martinhol221/SIM800L_DTMF_control/img/1.6x4.JPG

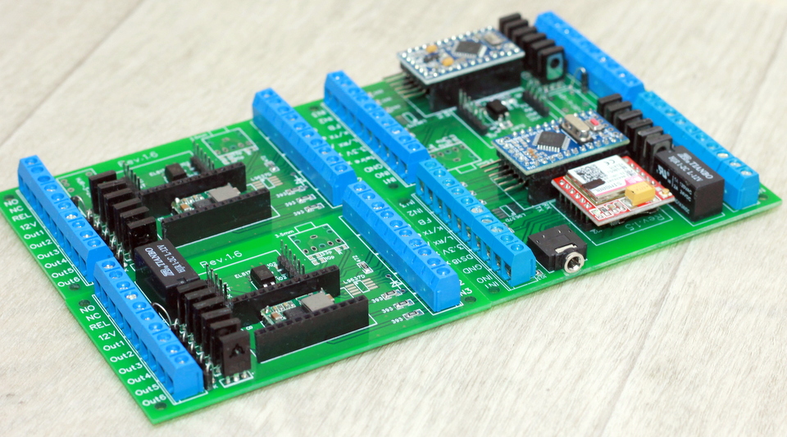
img/1.6x4.JPG
