martinhol221/SIM800L_DTMF_control/img/1.7.6.bottom.jpg

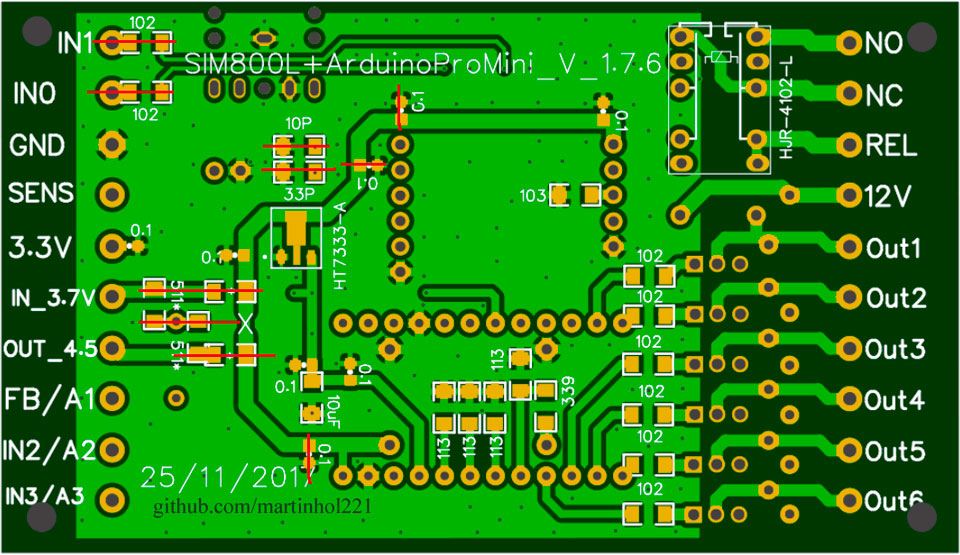
img/1.7.6.bottom.jpg
