martinhol221/SIM800L_DTMF_control/img/1.7.6.top.jpg

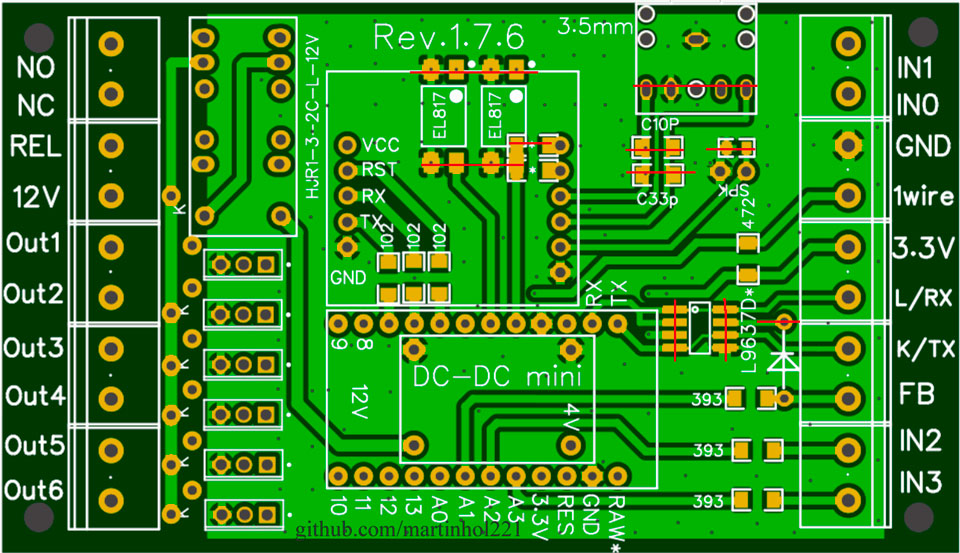
img/1.7.6.top.jpg
