martinhol221/SIM800L_DTMF_control/img/1N4007.jpg

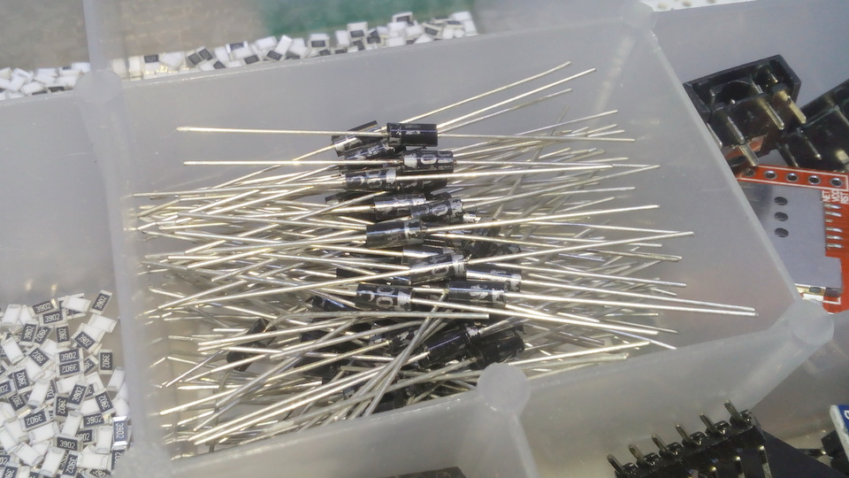
img/1N4007.jpg
