martinhol221/SIM800L_DTMF_control/img/5.08.jpg

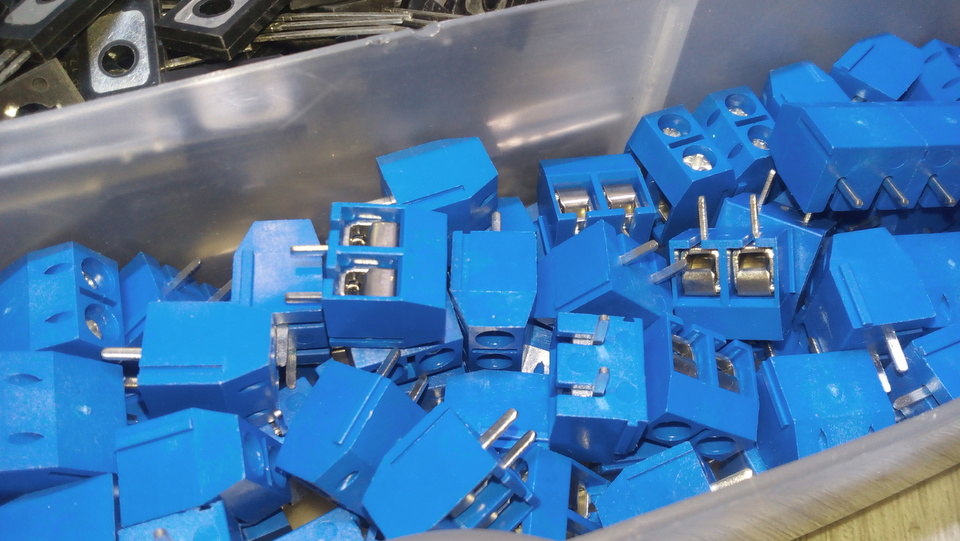
img/5.08.jpg
