martinhol221/SIM800L_DTMF_control/img/139.JPG

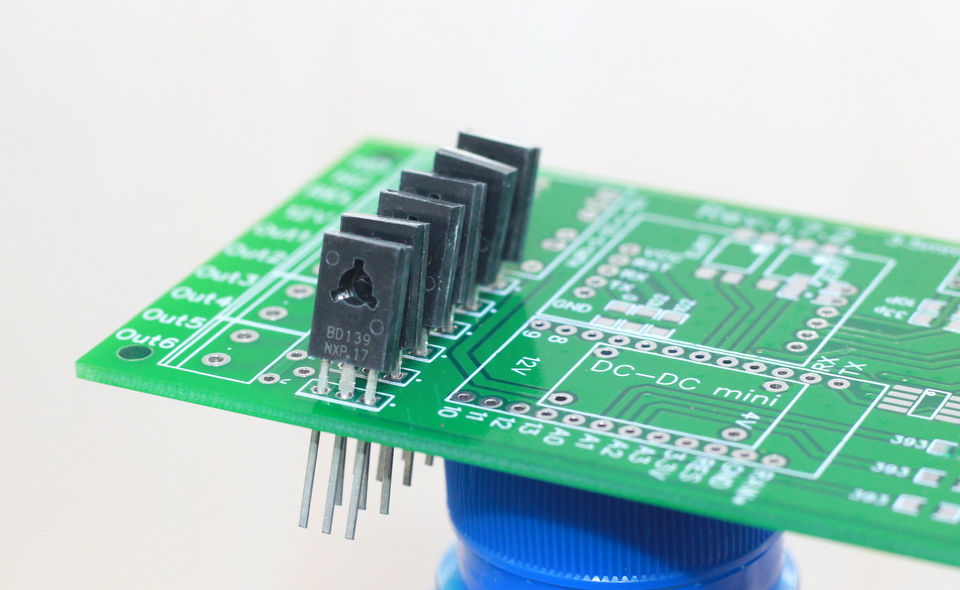
img/139.JPG
