martinhol221/SIM800L_DTMF_control/img/1206.jpg

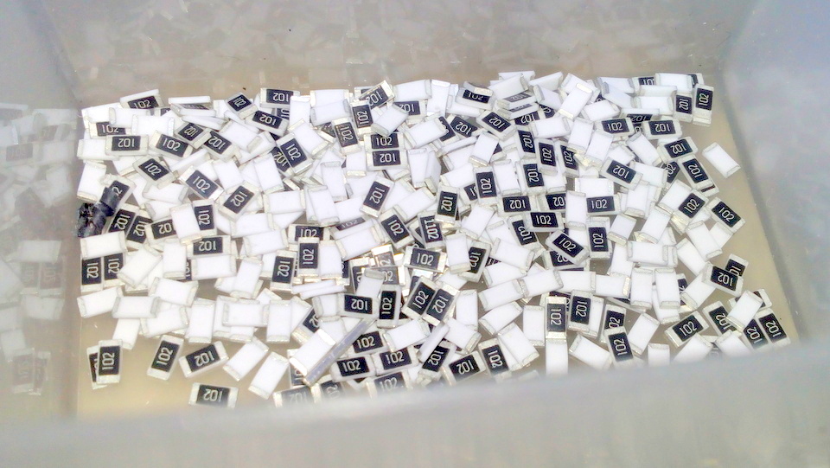
img/1206.jpg
