martinhol221/SIM800L_DTMF_control/img/+3DS18B20.JPG

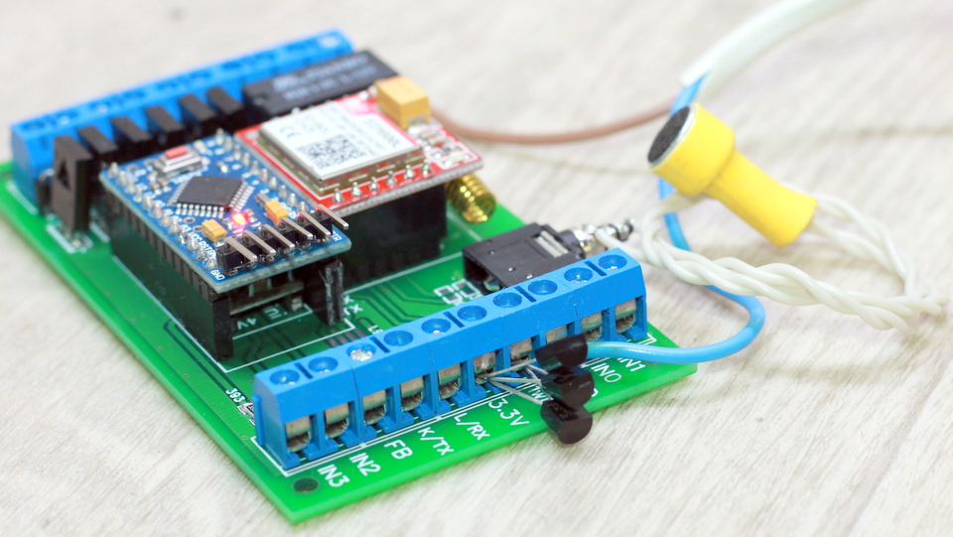
img/+3DS18B20.JPG
