martinhol221/SIM800L_DTMF_control/img/+ANT.JPG

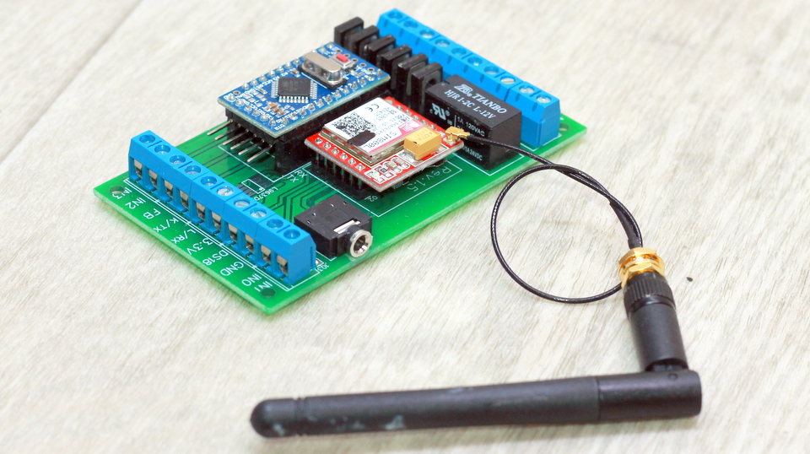
img/+ANT.JPG
