martinhol221/SIM800L_DTMF_control/img/+BD139+1N4007.JPG

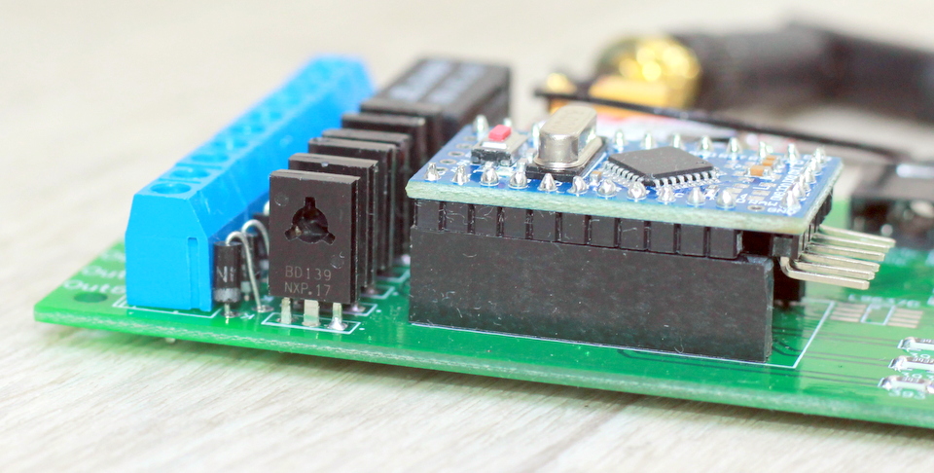
img/+BD139+1N4007.JPG
