martinhol221/SIM800L_DTMF_control/img/Arduino+Sim800l.JPG

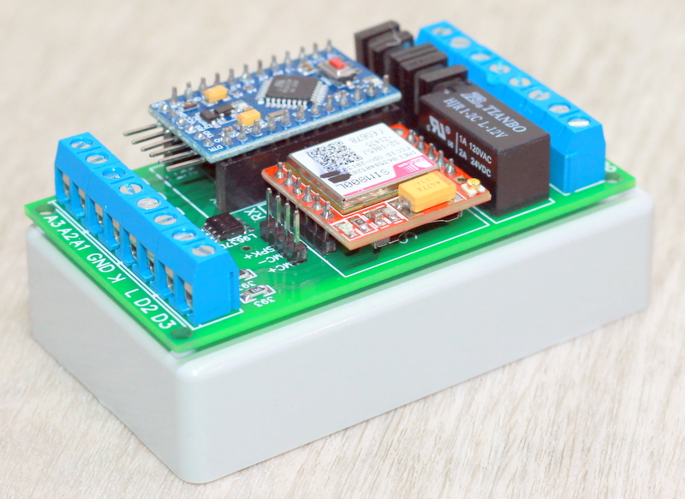
img/Arduino+Sim800l.JPG
