martinhol221/SIM800L_DTMF_control/img/ArduinoProMini.jpg

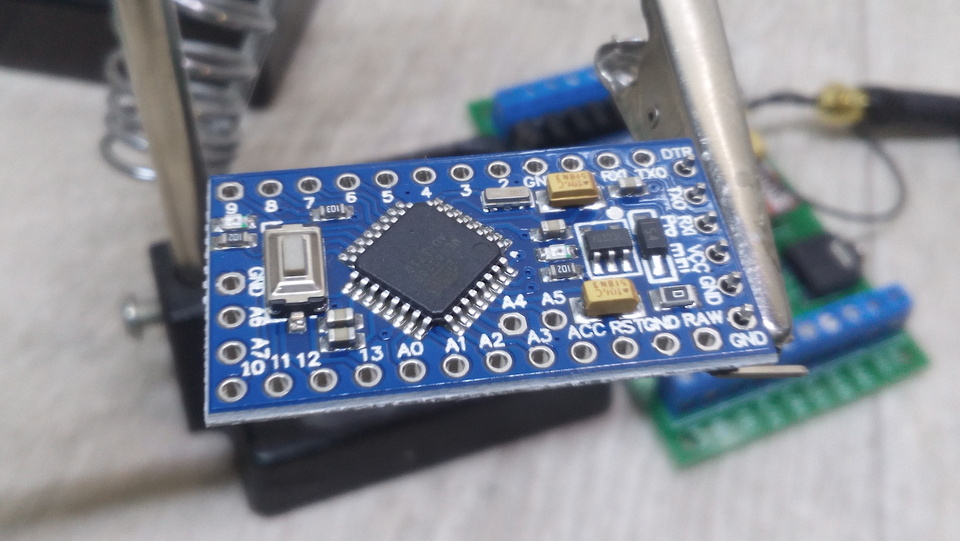
img/ArduinoProMini.jpg
