martinhol221/SIM800L_DTMF_control/img/autostart.jpg

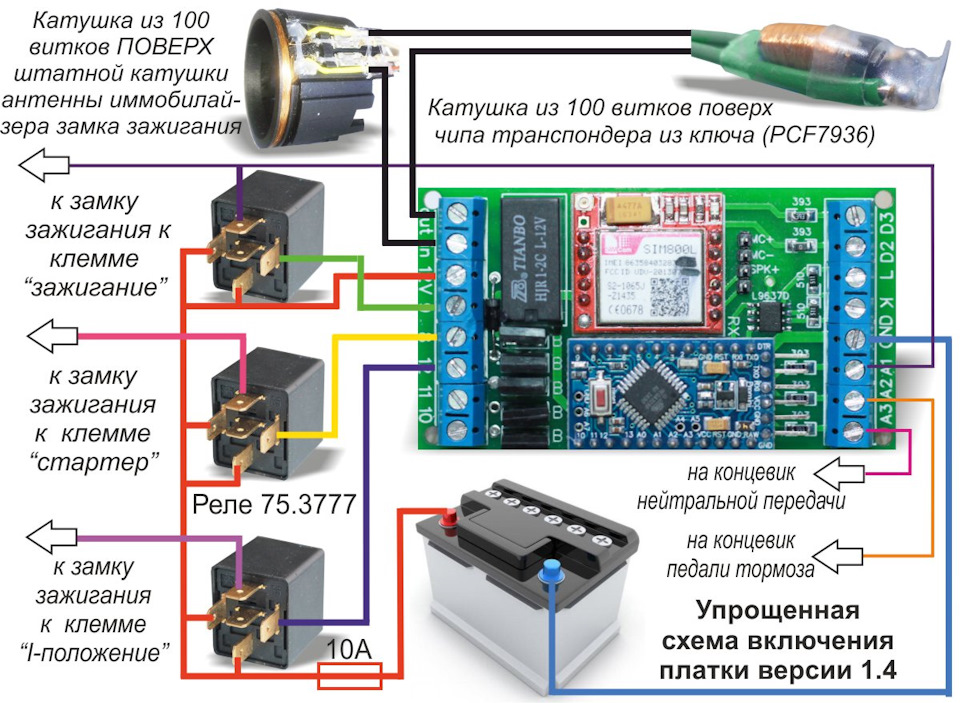
img/autostart.jpg
