martinhol221/SIM800L_DTMF_control/img/BD139.jpg

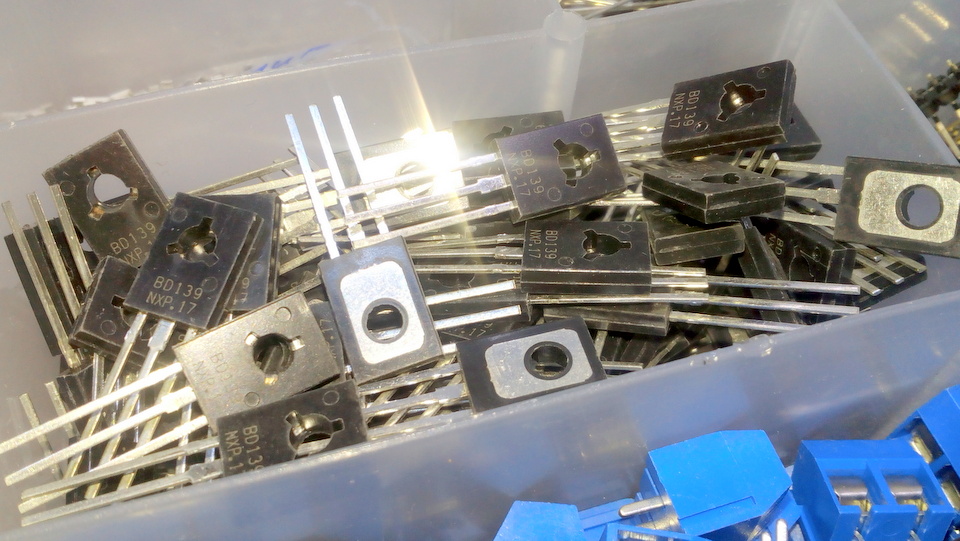
img/BD139.jpg
