martinhol221/SIM800L_DTMF_control/img/DC-DC-Mini-27K.jpg

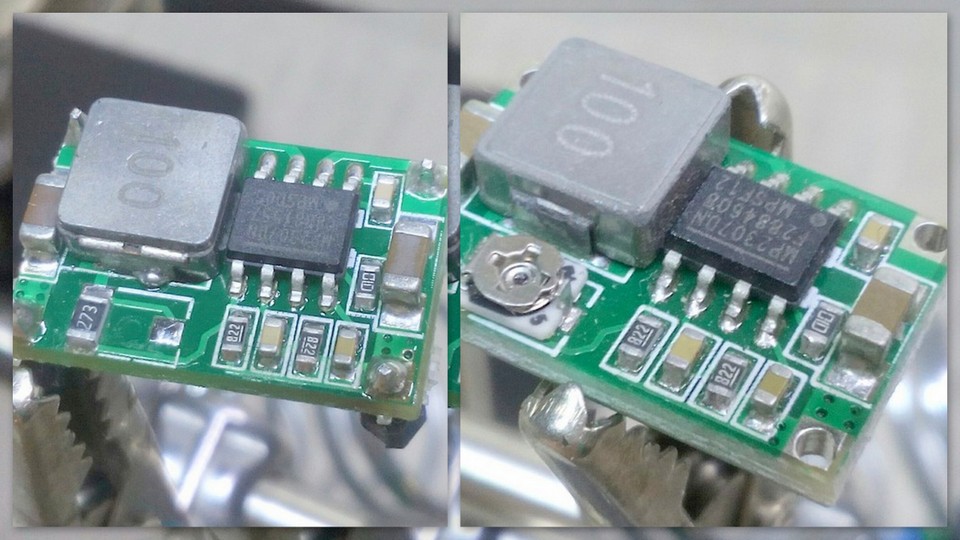
img/DC-DC-Mini-27K.jpg
