martinhol221/SIM800L_DTMF_control/img/Ds18B20.jpg

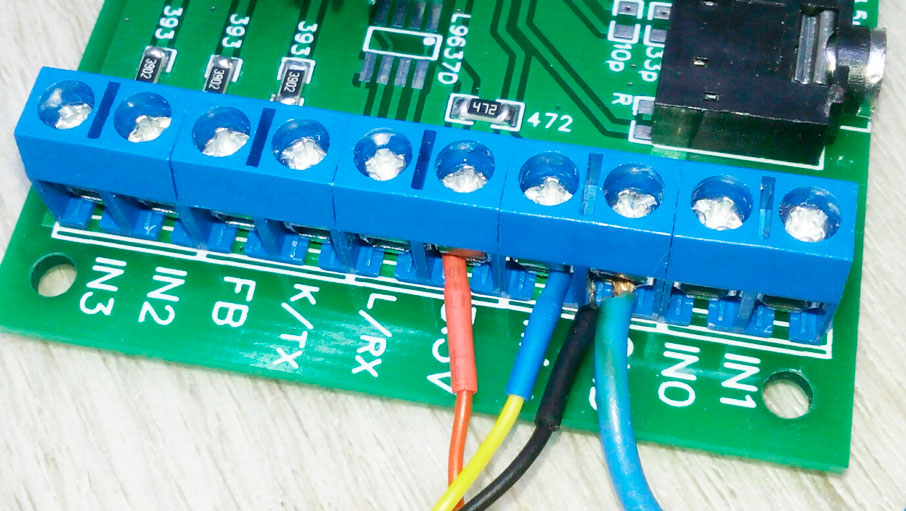
img/Ds18B20.jpg
