martinhol221/SIM800L_DTMF_control/img/HJR1-2CL12V.jpg

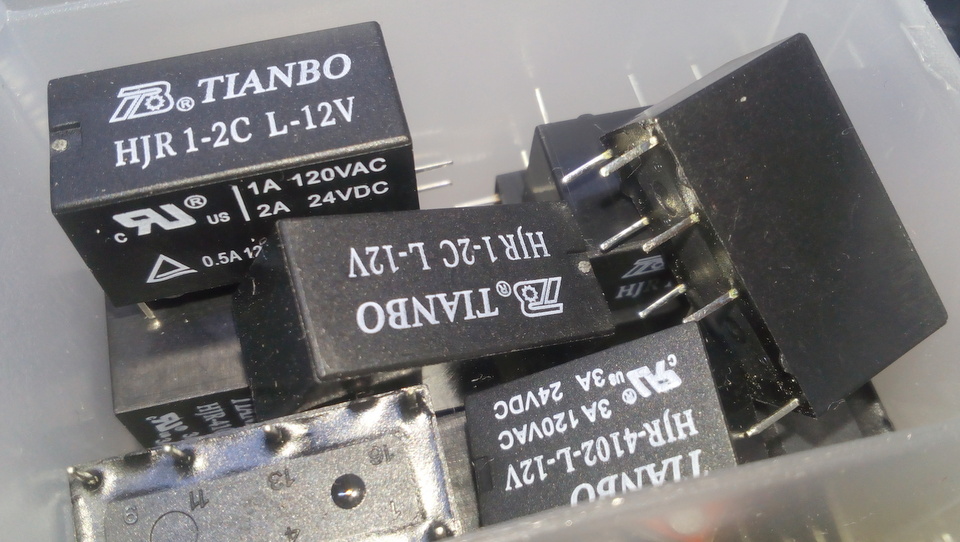
img/HJR1-2CL12V.jpg
