martinhol221/SIM800L_DTMF_control/img/inSMS3.jpg

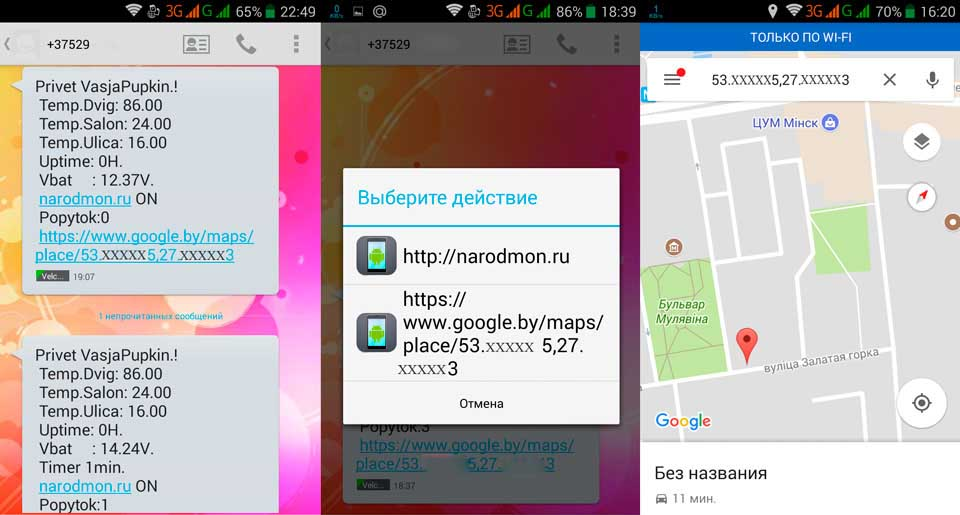
img/inSMS3.jpg
