martinhol221/SIM800L_DTMF_control/img/load_audio.JPG

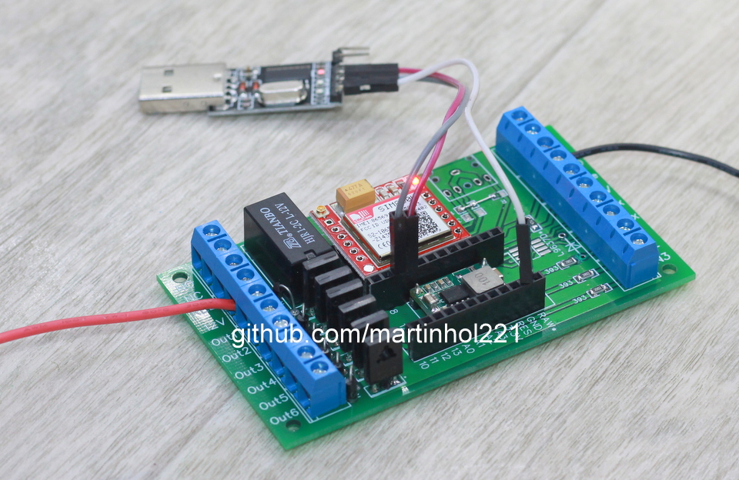
img/load_audio.JPG
