martinhol221/SIM800L_DTMF_control/img/No modem.JPG

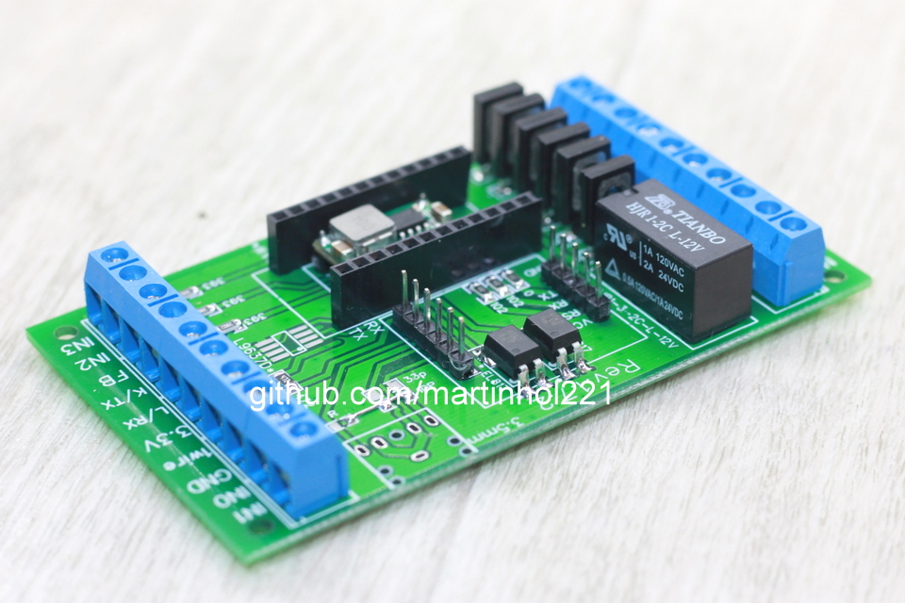
img/No modem.JPG
