martinhol221/SIM800L_DTMF_control/img/Series_ArmFile_Download_v1.00.JPG

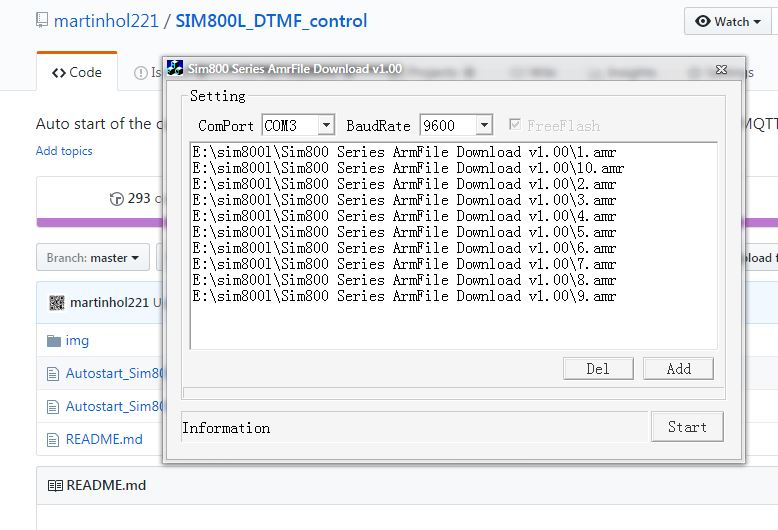
img/Series_ArmFile_Download_v1.00.JPG
