martinhol221/SIM800L_DTMF_control/img/Sim800L_red.jpg

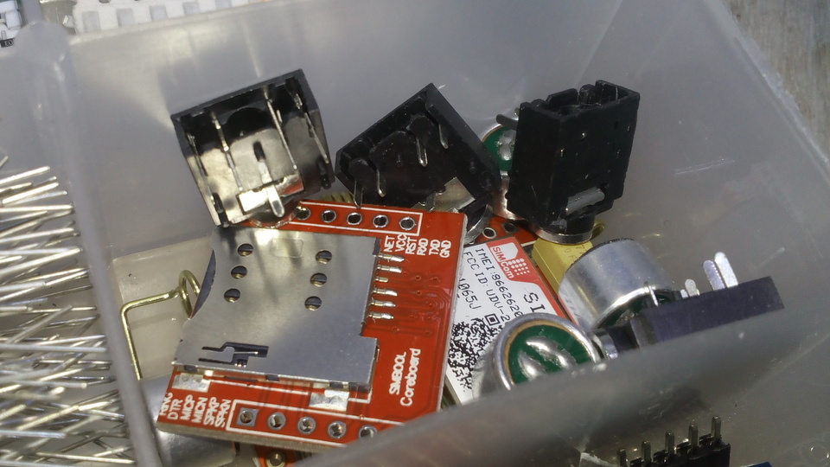
img/Sim800L_red.jpg
