martinhol221/SIM800L_DTMF_control/img/SIM.JPG

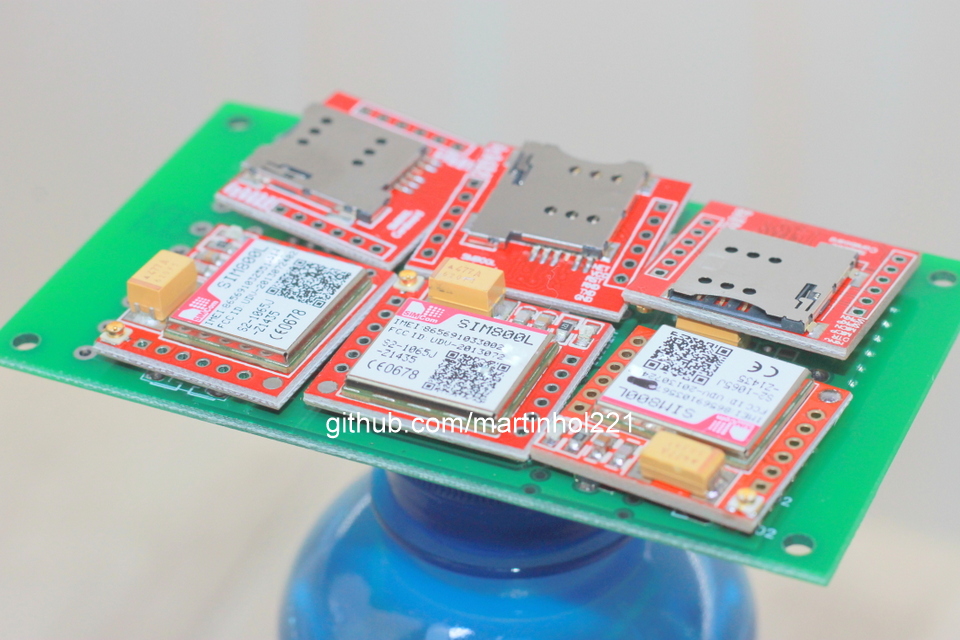
img/SIM.JPG
