martinhol221/SIM800L_DTMF_control/img/TempDS0-StTime_Timer.JPG

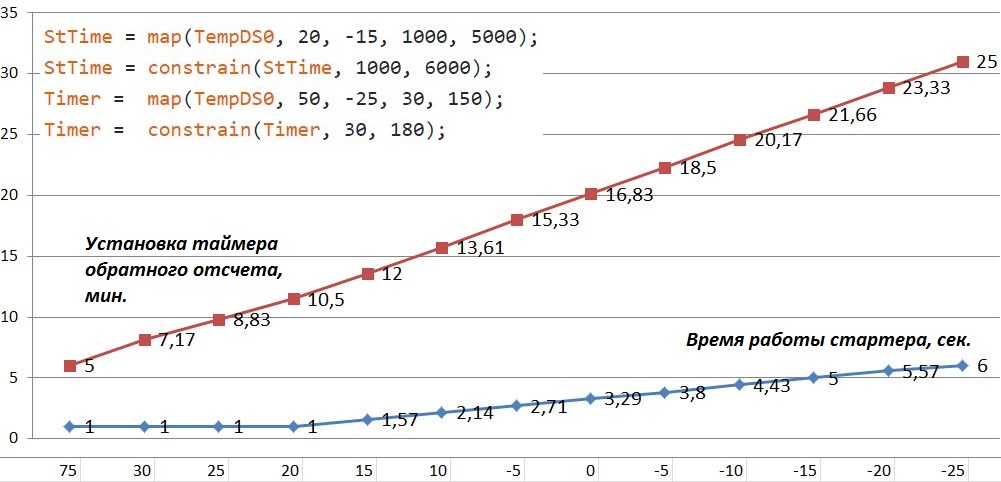
img/TempDS0-StTime_Timer.JPG
