martinhol221/SIM800L_DTMF_control/img/UART.JPG

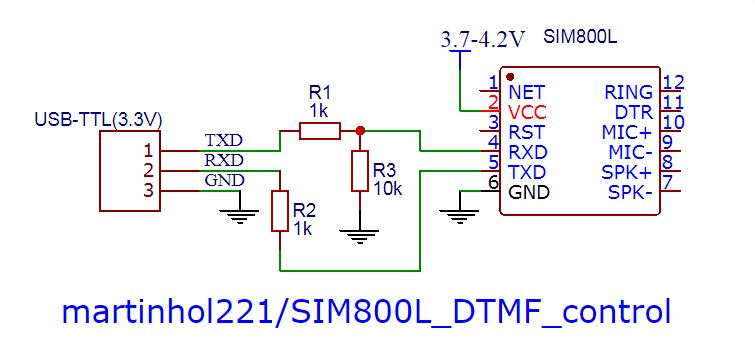
img/UART.JPG
