martinhol221/SIM800L_DTMF_control/img/lower_soldering.JPG

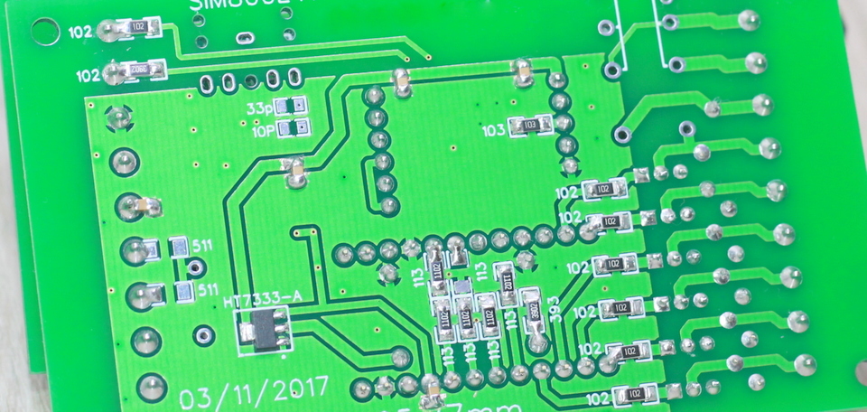
img/lower_soldering.JPG
