martinhol221/SIM800L_DTMF_control/img/upper_soldering.JPG

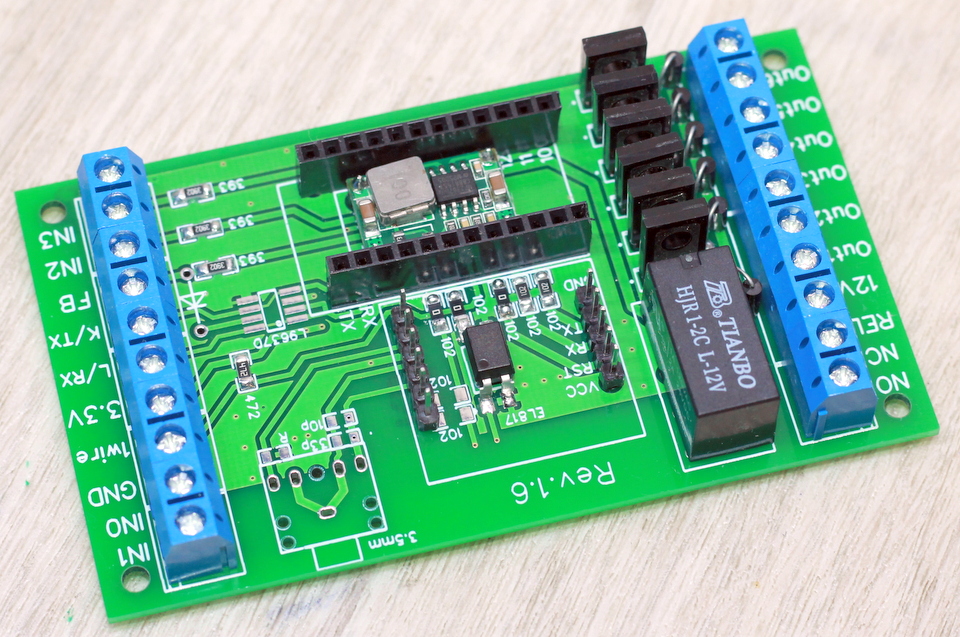
img/upper_soldering.JPG
