martinhol221/SIM800L_DTMF_control/(threads)

Thread 2 (2019-02-12):

Firmware 1418B04SIM800L24

steluis, 2019-02-12:
Where can I download the software version you mention 1418B04SIM800L24 ?
Seems that it is not present in SumCom official site.

Thank you.

roamirwilliams, 2020-08-07:
Revision:1418B05SIM800L24

https://yadi.sk/d/90-nlF22p7XN7A

bikicviki, 2023-02-26:
Did anybody find revision 1418B04SIM800L24 ?
Thanks in advance ...

iterr0R, 2023-04-11:
> Did anybody find revision 1418B04SIM800L24 ? Thanks in advance ...

Did you find it or are u still looking?

bikicviki, 2023-04-11:
No I didn't but problem was gsm modul sim800L not firmware .. Thakns for reply .. :)

HONAHONDE, 2023-12-09:
> > Quelqu'un a-t-il trouvé la révision 1418B04SIM800L24 ? Merci d'avance ...
>
> L'avez-vous trouvé ou vous cherchez toujours ?

je le cherche moi, pouvez-vous m'aider ?

HONAHONDE, 2023-12-09:
> > Did anybody find revision 1418B04SIM800L24 ? Thanks in advance ...
>
> Did you find it or are u still looking?

I'm looking for it, can you help me?

Electro-Gamma, 2024-08-05:
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

Are you find it??

bikicviki, 2024-08-12:
No I did not ..

On Mon, Aug 5, 2024 at 6:51 PM Electro-Gamma ***@***.***>
wrote:

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

Thread 3 (2019-12-30):

dtmf

atulgo, 2019-12-30:
Detection of DTMF tones in my SIM800L module.

I get "OK" when I send 'AT+DDET=1,1000,1,1* ' over uart .
But it doesnt seem to detect anything afterwards.
Perhaps I am doing something wrong.
Would be great to get some feedback.

regards
Atul
ref : *SIM800 Series_AT Command Manual_V1.09
