martinhol221/SIM800L_DTMF_control/img/Shema.pdf

4.0V

3.3V

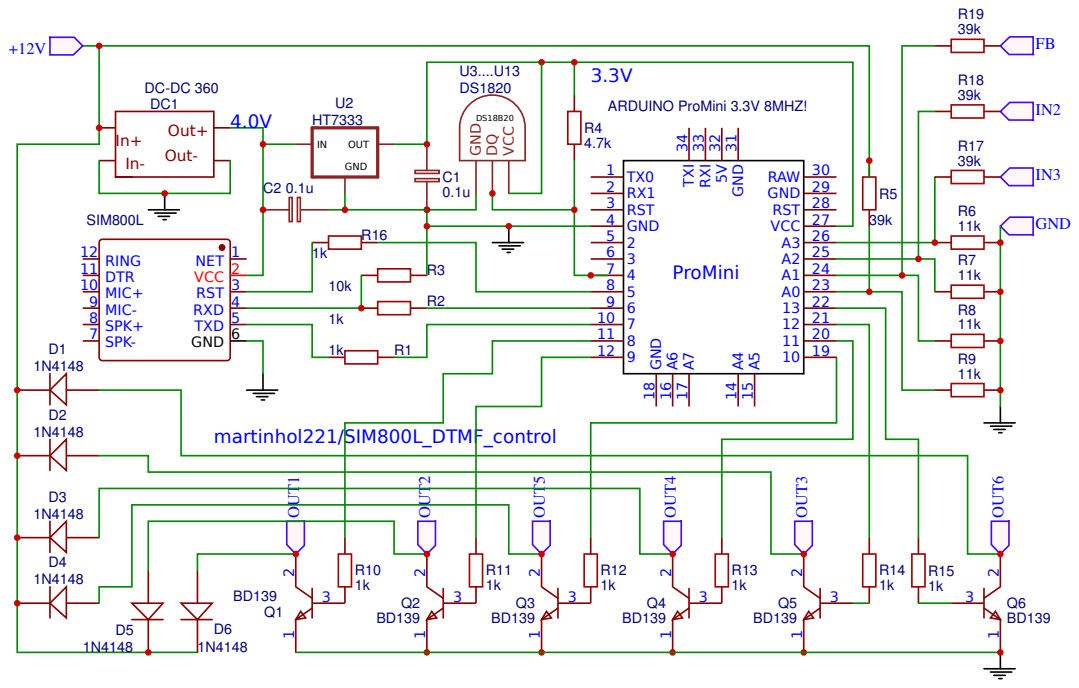
[picture p41: page 1]

GND 6 SPK- 7 SPK+ 8 MIC- 9 MIC+ 10 DTR 11 RING 12
