martinhol221/SIM800L_DTMF_control/(list of files, drawings)

Other design files:
SIM800L+ArduinoProMini-81x46mm.lay6
SIM800L+ArduinoProMini-81x70mm.lay6
