martinhol221/SIM800L_DTMF_control/img/RelTester.ino

// the setup function runs once when you press reset or power the board
void setup() {
  // initialize digital pin LED_BUILTIN as an output.
  pinMode(8, OUTPUT);
    pinMode(9, OUTPUT);
      pinMode(10, OUTPUT);
        pinMode(11, OUTPUT);
          pinMode(12, OUTPUT);
}

// the loop function runs over and over again forever
void loop() {
  digitalWrite(8, HIGH),  delay(1000), digitalWrite(8, LOW), delay(1000);   
  digitalWrite(9, HIGH),  delay(1000), digitalWrite(9, LOW), delay(1000);   
  digitalWrite(12, HIGH), delay(1000), digitalWrite(12, LOW), delay(1000);   
  digitalWrite(11, HIGH), delay(1000), digitalWrite(11, LOW), delay(1000);   
  digitalWrite(10, HIGH), delay(1000), digitalWrite(10, LOW), delay(1000);   
  digitalWrite(13, HIGH), delay(1000), digitalWrite(13, LOW), delay(1000);                      
}
