martinhol221/SIM800L_DTMF_control/(commit log)

2017-05-05 Слой паяльной маски на плату
2017-05-05 Печатная плата, негативная (для фоторезиста)
2017-05-05 Печатная плата, позитивная (для ЛУТа)
    Модемы SIM800L и M590 для Arduino ProMini под разные корпуса
2017-05-05 Расположение деталей на платах
    Расположение деталей на платах под разные корпуса, вид со стороны пайки
2017-05-05 Схема блока управления на модеме SIM800L
    Схема блока управления на модеме SIM800L в самой полной версии, в отличии от лайт версии имеет зарядку и литиевый аккумулятор.
2017-05-05 Схема подключения блока к автомобилю
    Схема подключения концевики педалей, датчики температуры, антенна эммобилайзера, силовое реле и другое
2017-05-05 Скетч для Arduino для GSM модема SIM800L
    Функции: обработка входящего звонка с заданным номером, реагирование на ввод DTMF команд (отправка смс отчета о состоянии систем и температуре с датчиков), команда запуска (3 попытки с контролем по датчику давления или зарядки), команда остановки двигателя.
2017-05-05 Исходники платы для SIM800L+Arduino 82x46мм
    [SIM800L+ArduinoProMini-81x46mm.lay6]
2017-05-05 Исходники платы для SIM800L+Arduino 82x70мм
    с платой защиты и литиевым аккумулятором типа 18650
    [SIM800L+ArduinoProMini-81x70mm.lay6]
2017-06-15 Изменения в цикле зпуска
2017-07-09 Скетч для управления Webasto
2017-07-09 Скетч управления Webasto
2017-10-04 Update Autostart_Citroen_V4.0_K-line_L9637D.ino
    added an additional relay for the first position of the ignition lock
2017-10-04 added an additional relay
    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
2017-10-10 добавлен автопрогрев при -18
2017-10-29 Create PCB
2017-11-09 кардинально изменен
2017-11-09 времнно не актуален
2017-11-27 лог нормальной работы
2017-12-02 Плата версии 1,6
2017-12-02 ArduinoProMini на 80Mhz
2017-12-02 SMD резисторы
2017-12-02 Шунтирующие диоды
2017-12-02 Клеммники с шагом 5.08
2017-12-02 DC-DC преобразователь
2017-12-02 Транзисторы
2017-12-02 Реле на обходчик иммобилайзера
2017-12-02 Модем на красной плате
2017-12-02 Расположение элементов на нижнем слое
2017-12-02 Расположение элементов на верхнем слое
2017-12-02 Правильное положение транзисторов
2017-12-02 Подключение датчиков температуры
2017-12-02 Подключение внешней антенны
2017-12-02 Процесс сборки
2017-12-02 Расположение в корпусе
2017-12-04 Расход трафика с геолокацией
2017-12-06 Подключение датчиков на проводе
2017-12-08 Актуальная стабильная версия
2017-12-10 Актуальный скетч
2017-12-10 Не актуальн
2017-12-12 Актуальная версия 4.2
2017-12-12 Тестовая версия
2017-12-25 Лог напряжения при дизеля 2.0 HDI
2017-12-28 Аудиофайлы для заливки в модем
2017-12-29 Скрин программы
2017-12-29 Добавлена функция автоответчика
2018-01-04 подключение к реле
2018-01-09 Обходчик иммобилайзера
2018-01-12 монтаж платки версии 1.7
2018-01-12 минимальный монтж версии 1,7
2018-02-28 Принципиальная упрощенная схема
